eman8388/ETHlink8ADC/snapshot_device_example/Image 2025-03-31 at 12.25.28.jpeg

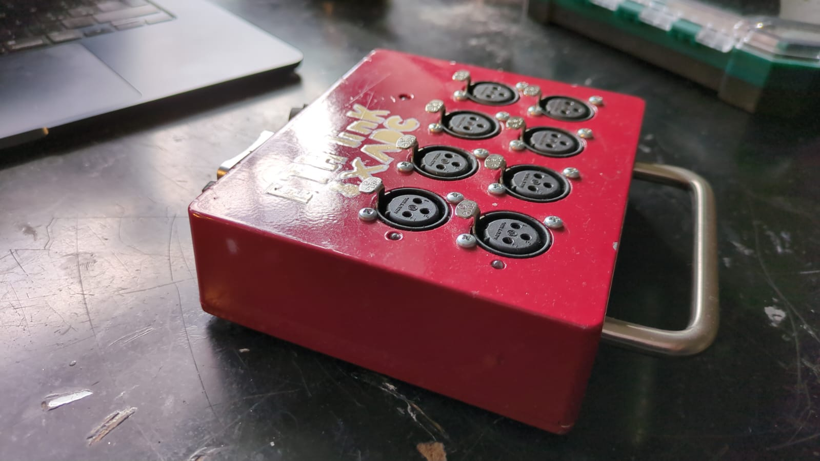
snapshot_device_example/Image 2025-03-31 at 12.25.28.jpeg
