eman8388/ETHlink8ADC/snapshot_PCB/3D_ETHlink8xADC_PCB_3D_2.png.png

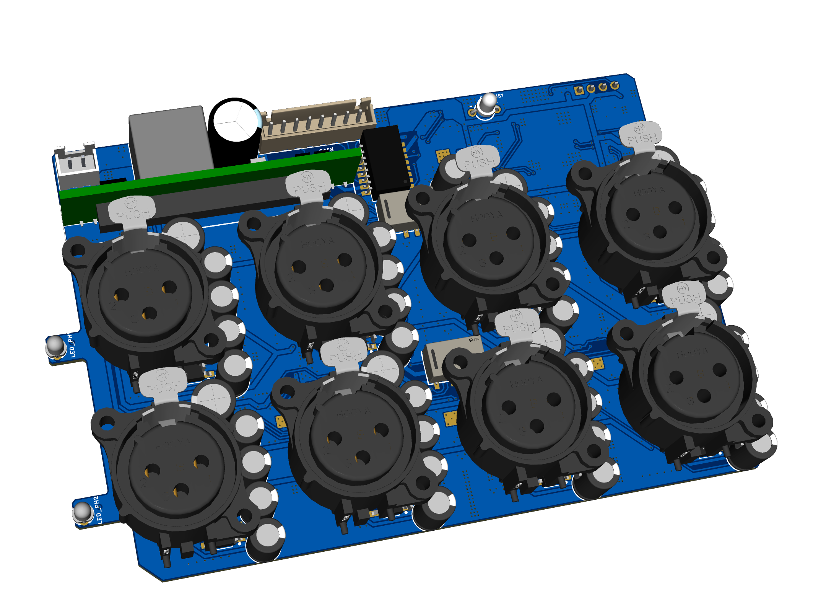
snapshot_PCB/3D_ETHlink8xADC_PCB_3D_2.png.png
