eman8388/ETHlink8ADC/PCB_BOM/BOM_ETHlink8xADC_ETHlink8xADC_Schematic.xlsx

No. | Comment | Designator | Footprint | Value | Manufacturer Part | Manufacturer | Supplier Part | Supplier | Quantity
1 | MB110S | B1,B2,B3,B4,B5,B6,B7,B8 | MBS_L4.7-W4.0-P2.50-LS7.0-TL |  | MB110S | MDD(辰达半导体) | C94545 | LCSC | 8
2 | 860020773013 | C1,C2,C3,C4,C20,C21,C22,C23,C32,C33,C34,C35,C44,C45,C46,C47,C57,C58,C59,C60,C69,C70,C71,C72,C81,C82,C83,C84,C93,C94,C95,C96,C240 | CAP-TH_BD6.3-P2.50-D0.5-FD |  | 860020773013 | Wurth(伍尔特) | C7046938 | LCSC | 33
3 | 100pF | C5,C13,C14,C25,C26,C37,C38,C48,C50,C51,C62,C63,C74,C75,C86,C87 | C0603 | 100pF | CL10C101JB8NNNC | SAMSUNG(三星) | C14858 | LCSC | 16
4 | 2.2nF | C6,C12,C24,C36,C49,C61,C73,C85 | C0603 | 2.2nF | GRM1885C1H222JA01D | muRata(村田) | C77033 | LCSC | 8
5 | 1000uF | C7,C17,C29,C41,C54,C66,C78,C90 | CAP-TH_BD8.0-P3.50-D0.6-FD-2 | 1000uF | 6.3YXS1000MEFC8X11.5 | rubycon(红宝石) | C5115430 | LCSC | 8
6 | 10uF | C8,C9,C15,C19,C27,C31,C39,C43,C52,C56,C64,C68,C76,C80,C88,C92,C97,C99,C100,C102,C104,C106,C108,C109,C111,C113,C184,C185,C194,C195,C196,C197,C202,C203,C204,C215,C218,C224 | C0603 | 10uF | CL10A106MQ8NNNC | SAMSUNG(三星) | C1691 | LCSC | 38
7 | 100nF | C10,C11,C16,C18,C28,C30,C40,C42,C53,C55,C65,C67,C77,C79,C89,C91,C98,C101,C103,C105,C107,C110,C112,C114,C115,C192,C193,C201,C214,C217,C223,C225,C230,C231,C232,C233,C234,C235,C236,C237,C241,C242 | C0603 | 100nF | CL10B104KC8NNNC | SAMSUNG(三星) | C15725 | LCSC | 42
8 | 1000uF | C198 | CAP-TH_BD10.0-P5.00-D1.0-FD | 1000uF | 25PK1000MEFC10*16 | rubycon(红宝石) | C109451 | LCSC | 1
9 | 1uF | C206,C207,C208,C210,C216 | C0603 | 1uF | CL10A105KB8NNNC | SAMSUNG(三星) | C15849 | LCSC | 5
10 | 10pF | C211,C219,C221 | C0603 | 10pF | CL10C100JB8NNNC | SAMSUNG(三星) | C1634 | LCSC | 3
11 | 4.7uF | C212 | C1210 | 4.7uF | HMK325C7475KN-TE | TAIYO YUDEN(太诱) | C697607 | LCSC | 1
12 | 470pF | C220 | C0603 | 470pF | CL10C471JC8NNNC | SAMSUNG(三星) | C525649 | LCSC | 1
13 | 2.2uF | C228,C229 | C0603 | 2.2uF | CL10A225KA8NNNC | SAMSUNG(三星) | C57895 | LCSC | 2
14 | 1N4148WS | D1,D2 | SOD-323_L1.7-W1.3-LS2.5-RD-1 |  | 1N4148WS | DIOTEC(德欧泰克) | C212832 | LCSC | 2
15 | SS34 | D3 | SMA_L4.3-W2.6-LS5.2-RD |  | SS34 | MDD | C8678 | LCSC | 1
16 | PMEG6010CEJ,115 | D4 | SOD-323F_L2.0-W1.6-LS2.5-RD |  | PMEG6010CEJ,115 | Nexperia(安世) | C406049 | LCSC | 1
17 | BZB984-C3V9,115 | D5,D6 | SOT-663-3_L1.6-W1.2-P1.00-LS1.6-BR |  | BZB984-C3V9,115 | Nexperia(安世) | C550162 | LCSC | 2
18 | MCP4017T-503E/LT | DP1,DP2,DP3,DP4,DP5,DP6,DP7,DP8 | SC-70-6_L2.0-W1.3-P0.65-LS2.1-BL |  | MCP4017T-503E/LT | MICROCHIP(美国微芯) | C478095 | LCSC | 8
19 | 4.7uH | L1 | IND-SMD_L7.0-W6.6_0630CDMCCDS | 4.7uH | 0630CDMCDDS-4R7MC | Sumida(胜美达) | C2453469 | LCSC | 1
20 | 6.8uH | L2 | IND-SMD_L7.3-W6.6 | 6.8uH | BMRA000606306R8MA1 | chilisin(奇力新) | C2838323 | LCSC | 1
21 | PT61017PEL | L3 | XFMR-SMD_PT61017PEL |  | PT61017PEL | BOURNS | C124001 | LCSC | 1
22 | 1uH | L4,L5 | L1008 | 1uH | LQM2HPN1R0MGHL | muRata(村田) | C162587 | LCSC | 2
23 | MHT192JGCT | LED1,LED2 | LED0603-RD |  | MHT192JGCT | MEIHUA(美华) | C473820 | LCSC | 2
24 | XL-302SURD | LED_PH1,LED_PH2 | LED-TH_BD3.8-P2.54-RD |  | XL-302SURD | XINGLIGHT(成兴光) | C2895470 | LCSC | 2
25 | DP9700 at-12V2A | POE_MODULE1 | PWRM-TH_DP9700-XX |  | DP9700 at-12V2A | SDAPO(达普) | C5380092 | LCSC | 1
26 | ZX-XH2.54-2PZZ | PWR_EXT1 | CONN-TH_2P-P2.50_HX25003-2A |  | ZX-XH2.54-2PZZ | Megastar(兆星) | C7429632 | LCSC | 1
27 | MMBT2222AT-7-F | Q1,Q2 | SOT-523-3_L1.6-W0.8-P1.00-LS1.6-BR |  | MMBT2222AT-7-F | DIODES(美台) | C151009 | LCSC | 2
28 | 10kΩ | R1,R2,R7,R8,R9,R10,R11,R12,R17,R18,R19,R20,R21,R22,R27,R28,R29,R30,R31,R32,R37,R38,R39,R40,R41,R42,R47,R48,R49,R50,R51,R52,R57,R58,R59,R60,R61,R62,R67,R68,R69,R70,R71,R72,R77,R78,R79,R80,R81,R82,R123,R144,R145,R146,R147 | R0603 | 10kΩ | RC0603FR-0710KL | YAGEO(国巨) | C98220 | LCSC | 55
29 | 12Ω | R3,R4,R13,R14,R23,R24,R33,R34,R43,R44,R53,R54,R63,R64,R73,R74 | R0603 | 12Ω | RC0603FR-0712RL | YAGEO(国巨) | C245909 | LCSC | 16
30 | 6.8kΩ | R5,R6,R15,R16,R25,R26,R35,R36,R45,R46,R55,R56,R65,R66,R75,R76 | R0805 | 6.8kΩ | AS05W2J0682T5E | UNI-ROYAL(厚声) | C560550 | LCSC | 16
31 | 4.7kΩ | R83,R84,R85,R86,R87,R88,R89,R90,R91,R92,R93,R94,R95,R96,R97,R98,R99,R116,R117,R134,R136,R137,R138,R140 | R0603 | 4.7kΩ | 0603WAF4701T5E | UNI-ROYAL(厚声) | C23162 | LCSC | 24
32 | 470Ω | R120,R121,R142,R143,R148,R149,R150,R151,R152 | R0603 | 470Ω | 0603WAF4700T5E | UNI-ROYAL(厚声) | C23179 | LCSC | 9
33 | 33kΩ | R124 | R0603 | 33kΩ | 0603WAF4702T5E | UNI-ROYAL(厚声) |  | LCSC | 1
34 | 1MΩ | R125 | R0603 | 1MΩ | 0603WAF1004T5E | UNI-ROYAL(厚声) | C22935 | LCSC | 1
35 | 34.8kΩ | R126 | R0603 | 34.8kΩ | 0603WAF3482T5E | UNI-ROYAL(厚声) | C23141 | LCSC | 1
36 | 47Ω | R127,R128,R129,R130,R132,R133,R139,R141 | R0603 | 47Ω | 0603WAF470JT5E | UNI-ROYAL(厚声) | C23182 | LCSC | 8
37 | 12.1kΩ | R131 | R0603 | 12.1kΩ | 0603WAF1212T5E | UNI-ROYAL(厚声) | C22864 | LCSC | 1
38 | 1.5kΩ | R135 | R0603 | 1.5kΩ | 0603WAF1501T5E | UNI-ROYAL(厚声) | C22843 | LCSC | 1
39 | B8B-XH-AM | RJ45 | CONN-TH_8P-P2.50_B8B-XH-AM-LF-SN |  | B8B-XH-AM | JST | C5306535 | LCSC | 1
40 | 209UYSYGW/S530-A3/R2 | STATUS1 | LED-TH_3P-BD4.0-P2.54 |  | 209UYSYGW/S530-A3/R2 | EVERLIGHT(亿光) | C409519 | LCSC | 1
41 | HB-PH3-25414PB2GOP | SW1 | HDR-TH_4P-P2.54-V-M |  | HB-PH3-25414PB2GOP | HANBO(汉博) | C6332197 | LCSC | 1
42 | LME49721MA/NOPB | U1,U2,U3,U4,U5,U6,U7,U8 | SOIC-8_L4.9-W3.9-P1.27-LS6.0-BL |  | LME49721MA/NOPB | TI(德州仪器) | C1348133 | LCSC | 8
43 | TLV320ADC6140IRTWT | U9,U10 | WQFN-24_L4.0-W4.0-P0.50-BL-EP2.1 |  | TLV320ADC6140IRTWT | TI(德州仪器) | C1852023 | LCSC | 2
44 | TCA9548ARGER | U11 | VQFN-24_L4.0-W4.0-P0.50-BL-EP2.5 |  | TCA9548ARGER | TI(德州仪器) | C555456 | LCSC | 1
45 | SI5351A-B-GTR | U16 | MSOP-10_L3.0-W3.0-P0.50-LS5.0-BL |  | SI5351A-B-GTR | SKYWORKS/SILICON LABS(芯科) | C504891 | LCSC | 1
46 | STM32H743VIT6 | U17 | LQFP-100_L14.0-W14.0-P0.50-LS16.0-BL |  | STM32H743VIT6 | ST(意法半导体) | C529058 | LCSC | 1
47 | AP62300WU-7 | U18 | TSOT-23-6_L2.9-W1.6-P0.95-LS2.8-BL |  | AP62300WU-7 | DIODES(美台) | C1880390 | LCSC | 1
48 | LD39200PUR | U19,U20 | DFN-6_L3.0-W3.0-P0.95-BL-EP-1 |  | LD39200PUR | ST(意法半导体) | C2969757 | LCSC | 2
49 | LT8330ES6#TRPBF | U21 | TSOT-23-6_L2.9-W1.6-P0.95-LS2.8-BR |  | LT8330ES6#TRPBF | ADI(亚德诺) | C673741 | LCSC | 1
50 | LAN8742A-CZ | U22 | QFN-24_L4.0-W4.0-P0.50-BL-EP2.6 |  | LAN8742A-CZ | MICROCHIP(美国微芯) | C220794 | LCSC | 1
51 | UD2-3NUN | U23,U24 | RELAY-SMD_KEMET_UD2-XXNUN |  | UD2-3NUN | KEMET(基美) | C1560780 | LCSC | 2
52 | 25MHz | X1,X2 | CRYSTAL-SMD_4P-L3.2-W2.5-BL | 25MHz | 7M-25.000MEEQ-T | TXC(晶技) | C2450106 | LCSC | 2
53 | NC3FAAV1 | XLR1,XLR2,XLR3,XLR4,XLR5,XLR6,XLR7,XLR8 | CONN-TH_NC3FAAV1 |  | NC3FAAV1 | NEUTRIK(优曲克) | C368513 | LCSC | 8
