eman8388/ETHlink8ADC/PCB_Schematic/SCH_ETHlink8xADC_Schematic.pdf

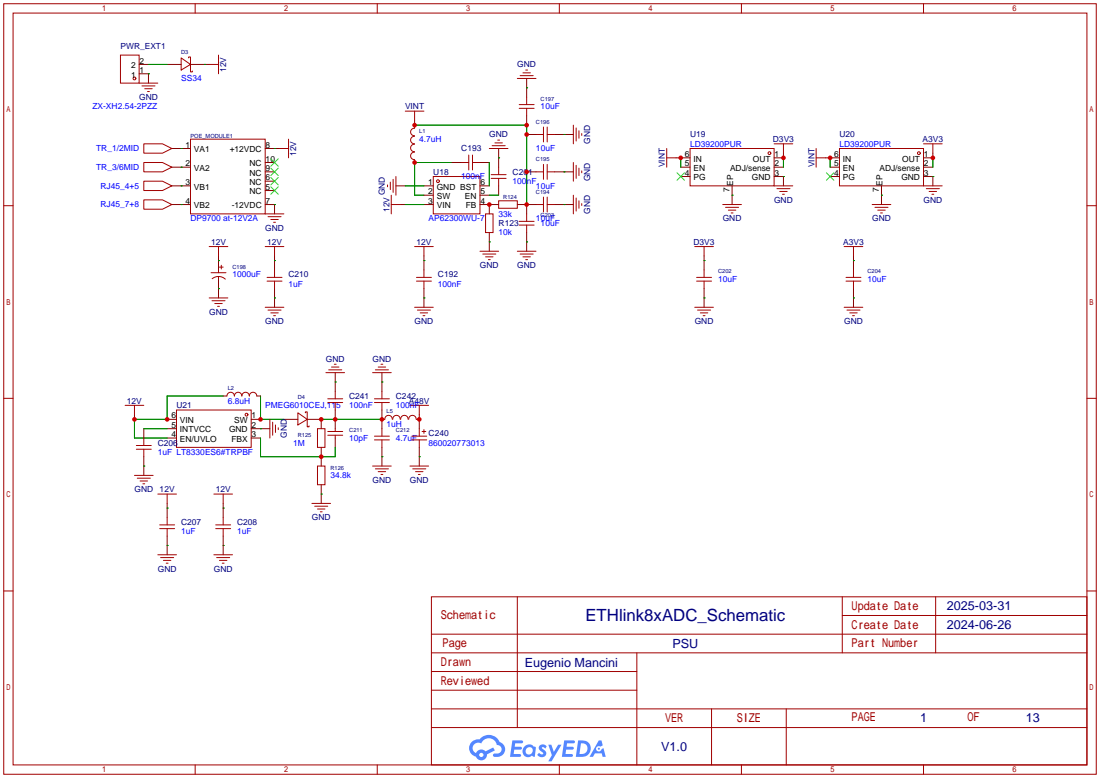
[picture p6: page 1]

VDD 50 PB12 51 PB13 52 PB14 53 PB15 54 PD8 55 PD9 56 PD10 57 PD11 58 PD12 59 PD13 60 PD14 61 PD15 62 PC6 63 PC7 64 PC8 65 PC9 66 PA8 67 PA9 68 PA10 69 PA11 70 PA12 71 PA13 72 VCAP 73 VSS 74 VDD 75 PA14 76 PA15 77 PC10 78 PC11 79 PC12 80 PD0 81 PD1 82 PD2 83 PD3 84 PD4 85 PD5 86 PD6 87 PD7 88 PB3 89 PB4 90 PB5 91 PB6 92 PB7 93 BOOT0 94 PB8 95 PB9 96 PE0 97 PE1 98 VSS 99 VDD 100

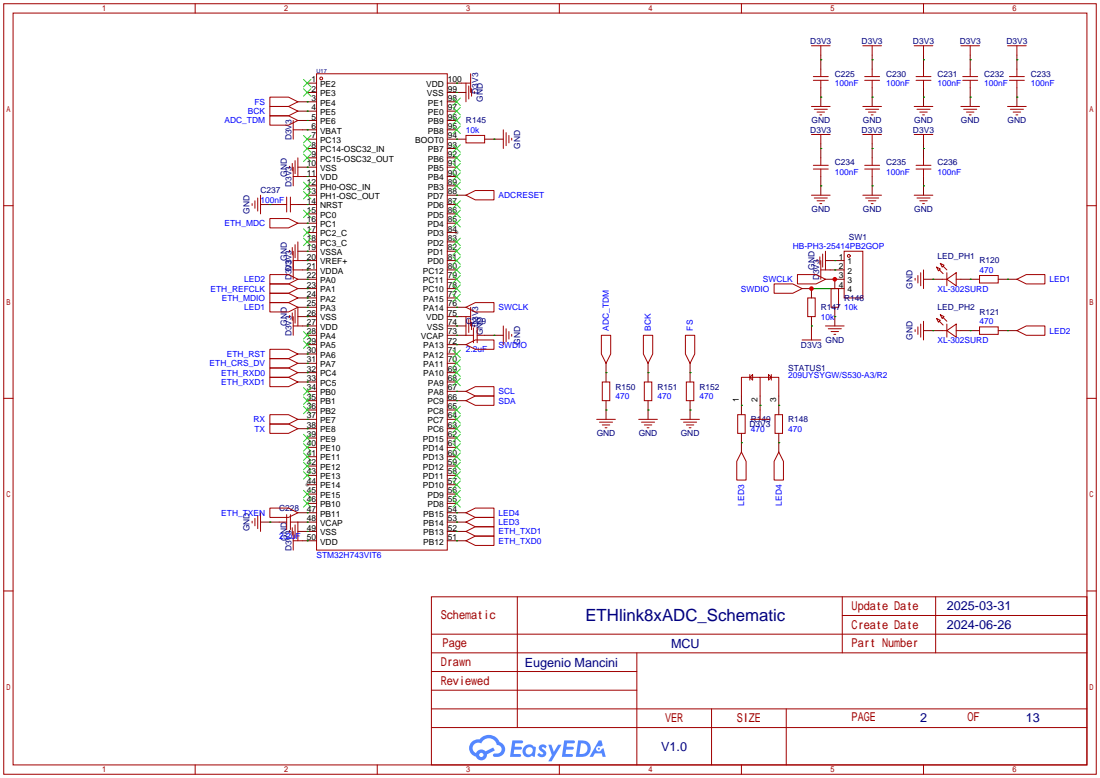
[picture p7: page 2]

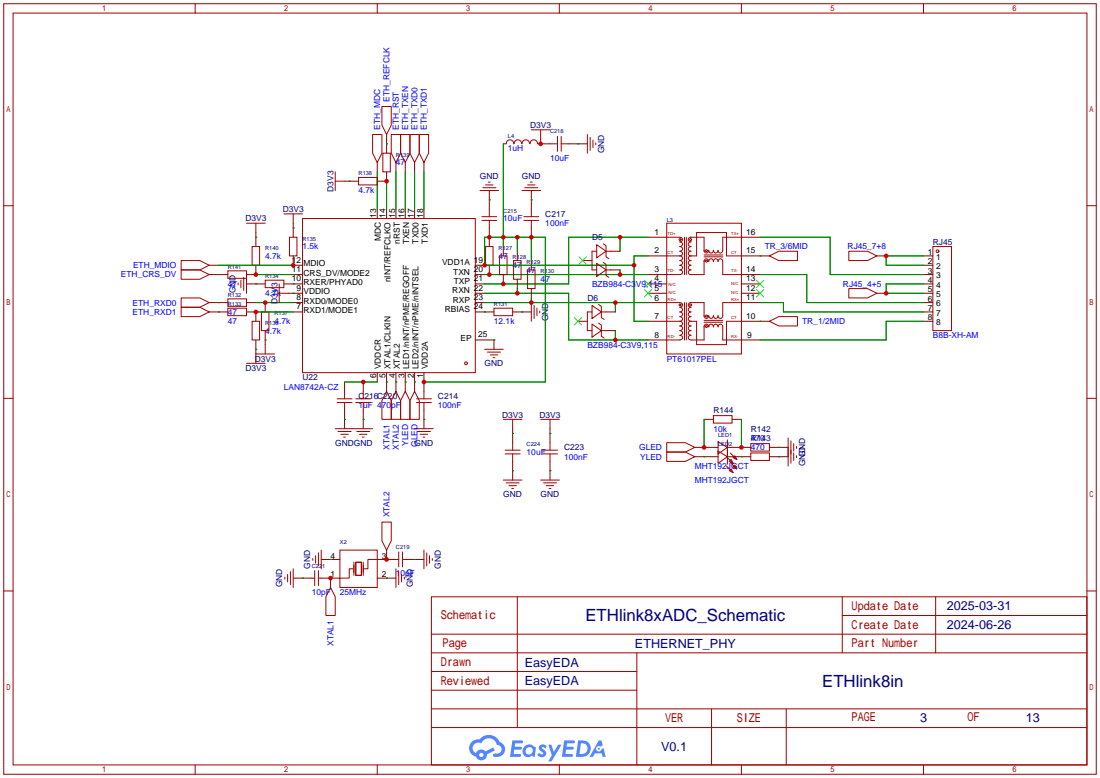
[picture p8: page 3]

TXD1 18 TXD0 17 TXEN 16 nRST 15 nINT/REFCLKO 14 MDC 13

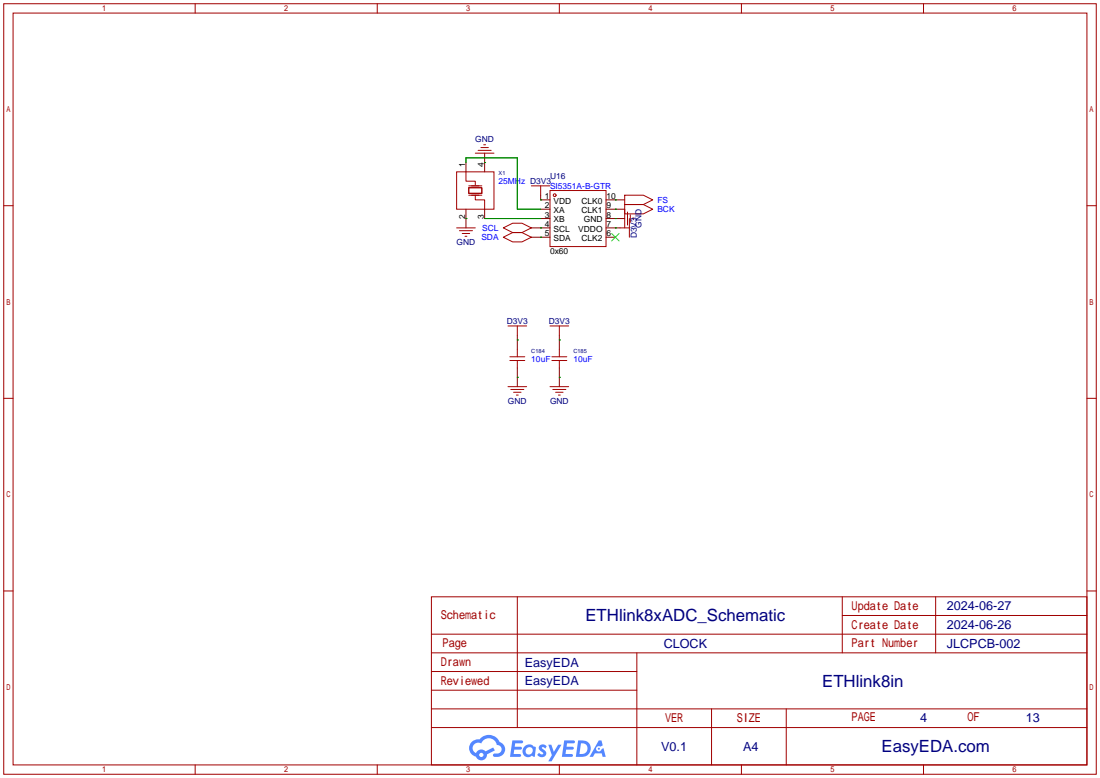
[picture p9: page 4]

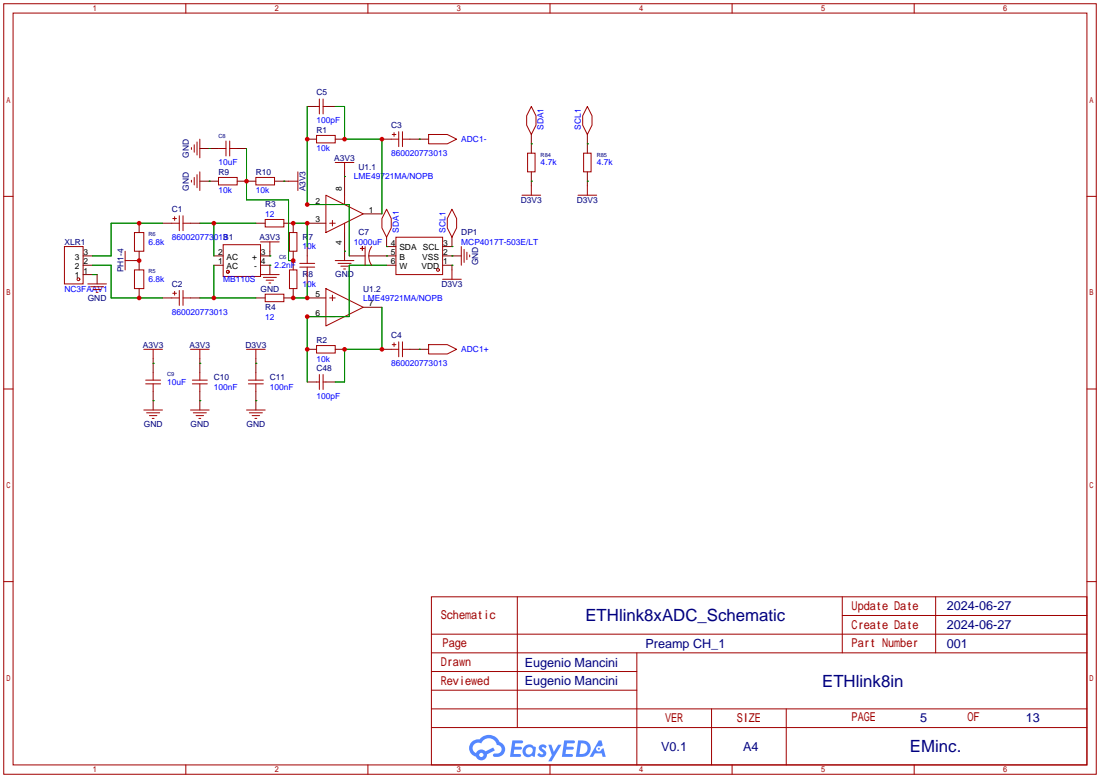
[picture p10: page 5]

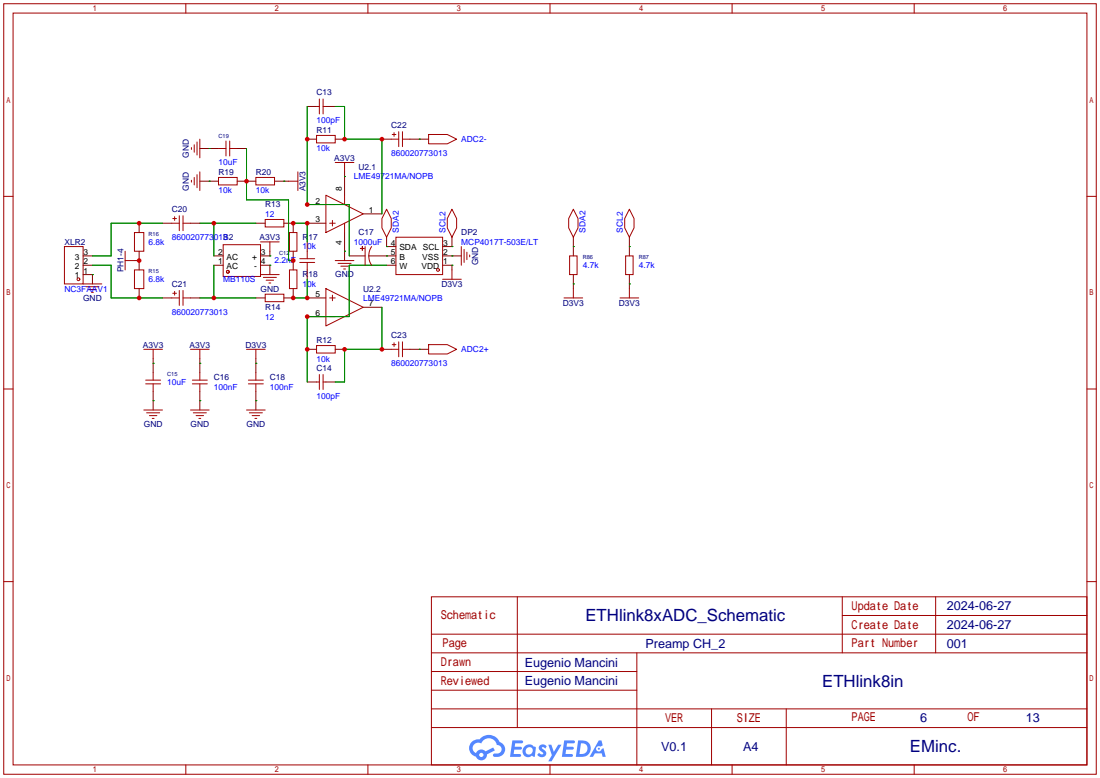
[picture p11: page 6]

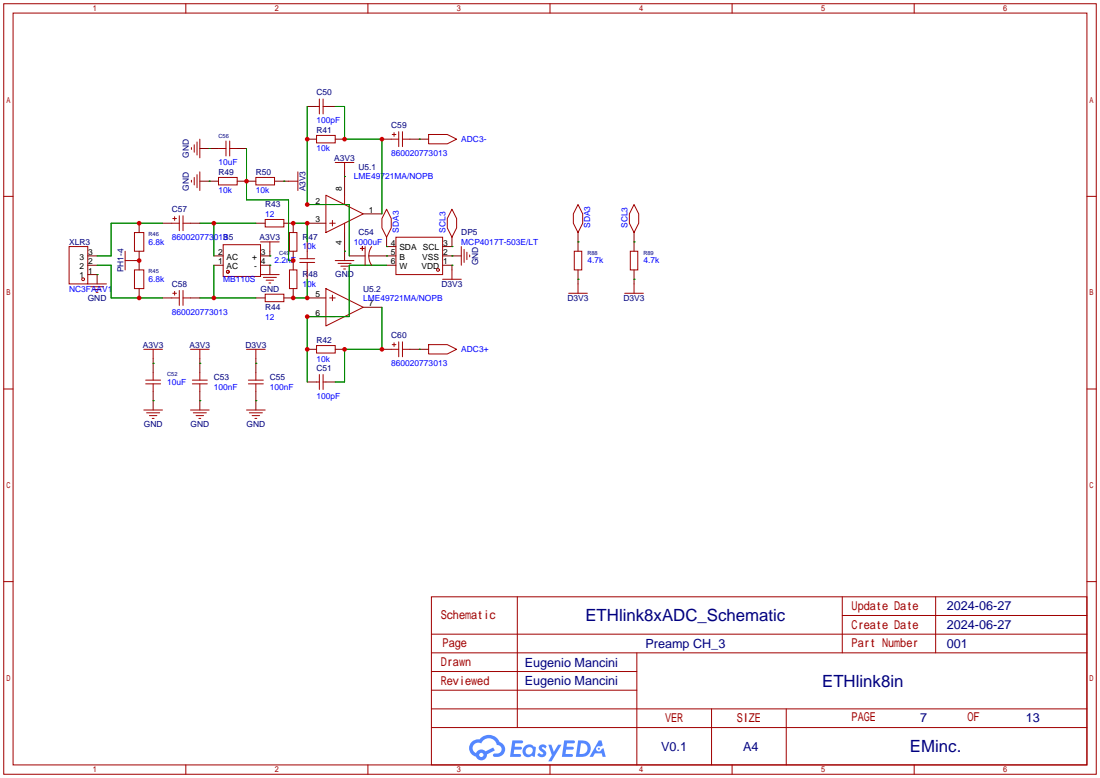
[picture p12: page 7]

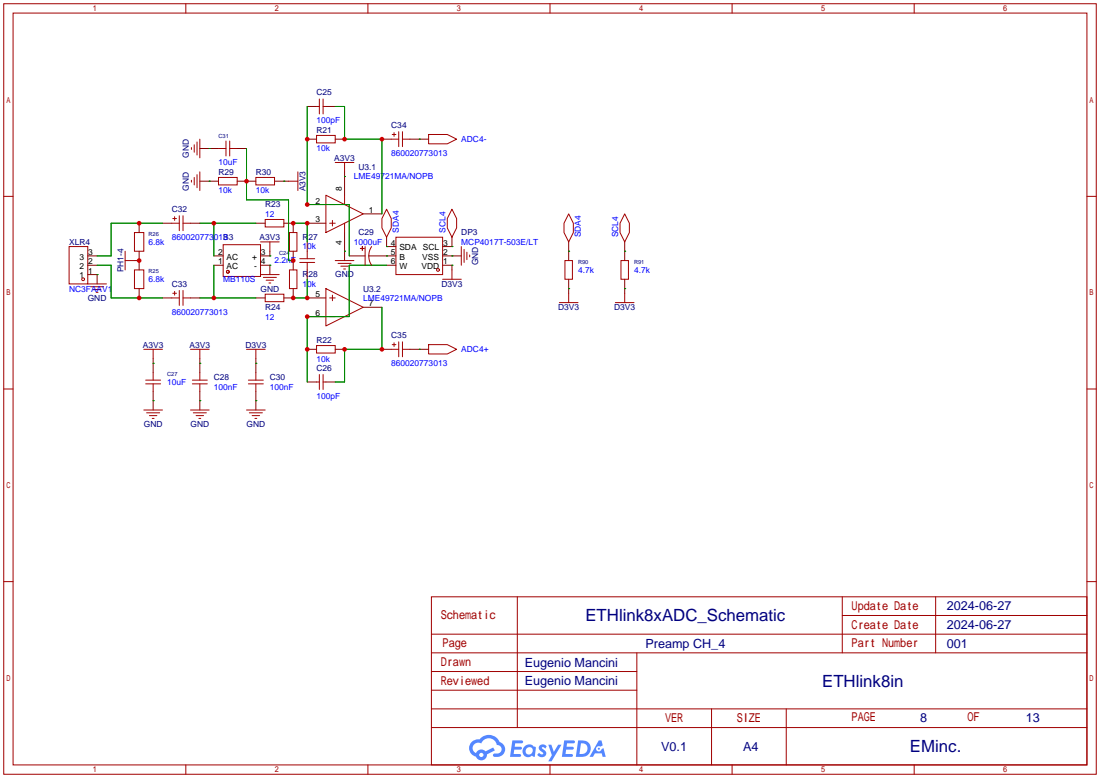
[picture p13: page 8]

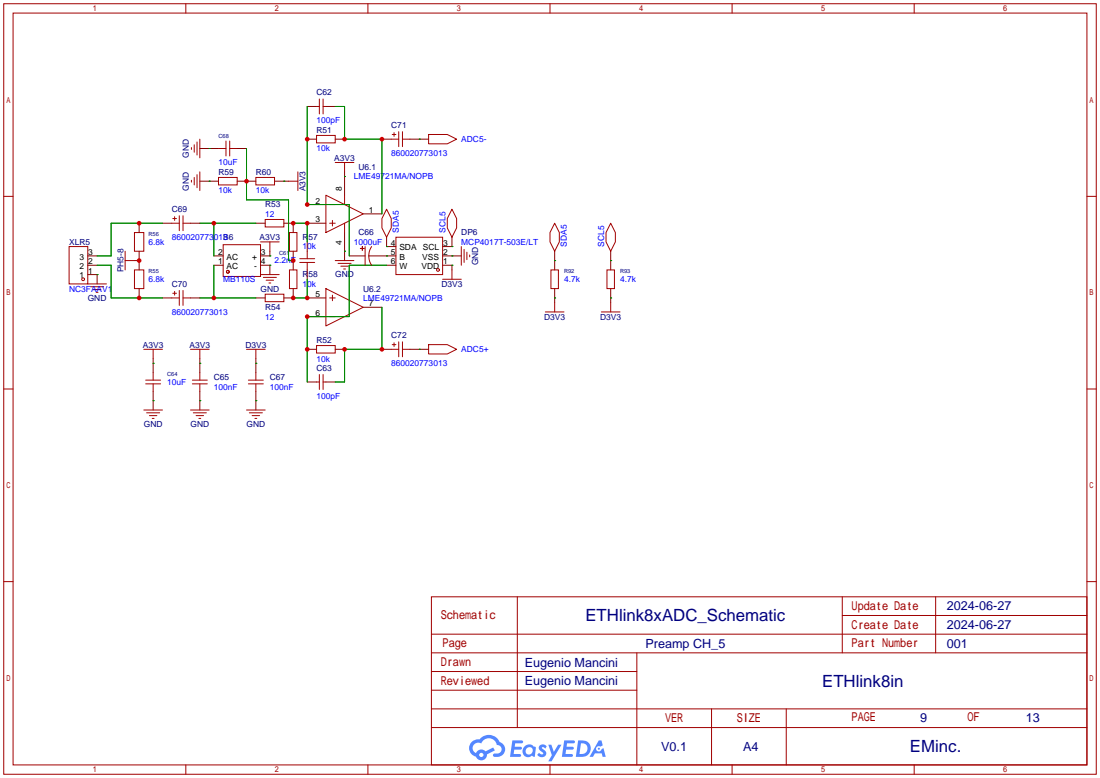
[picture p14: page 9]

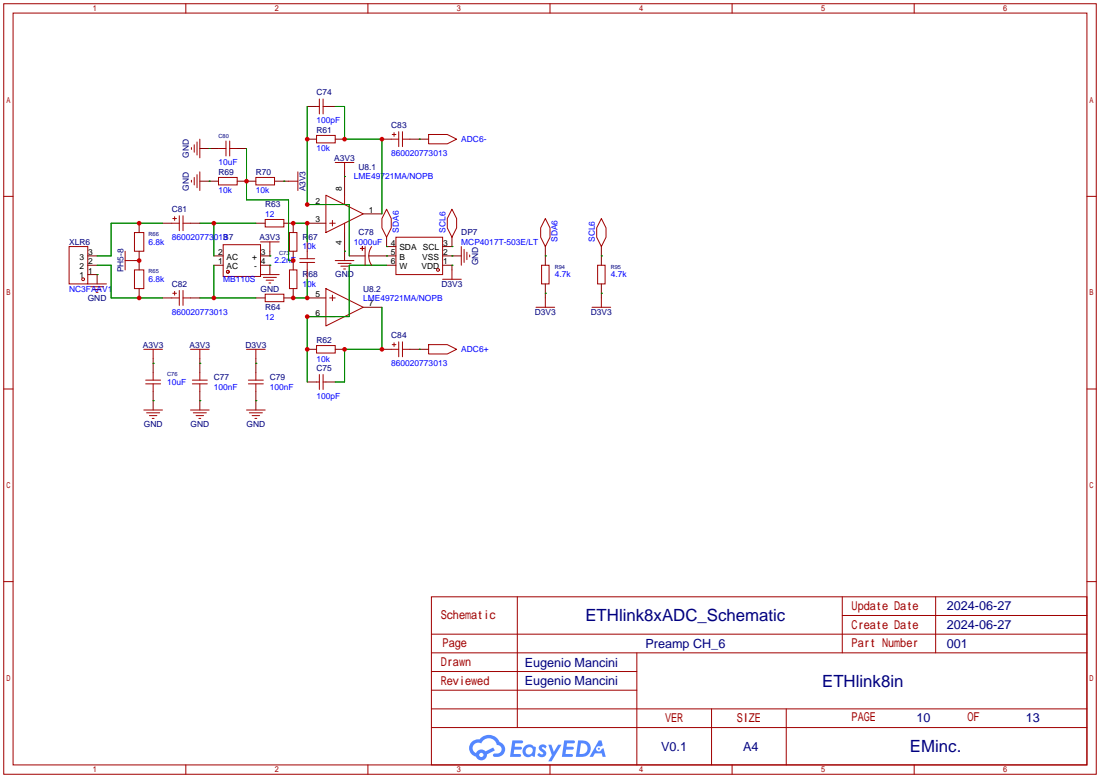
[picture p15: page 10]

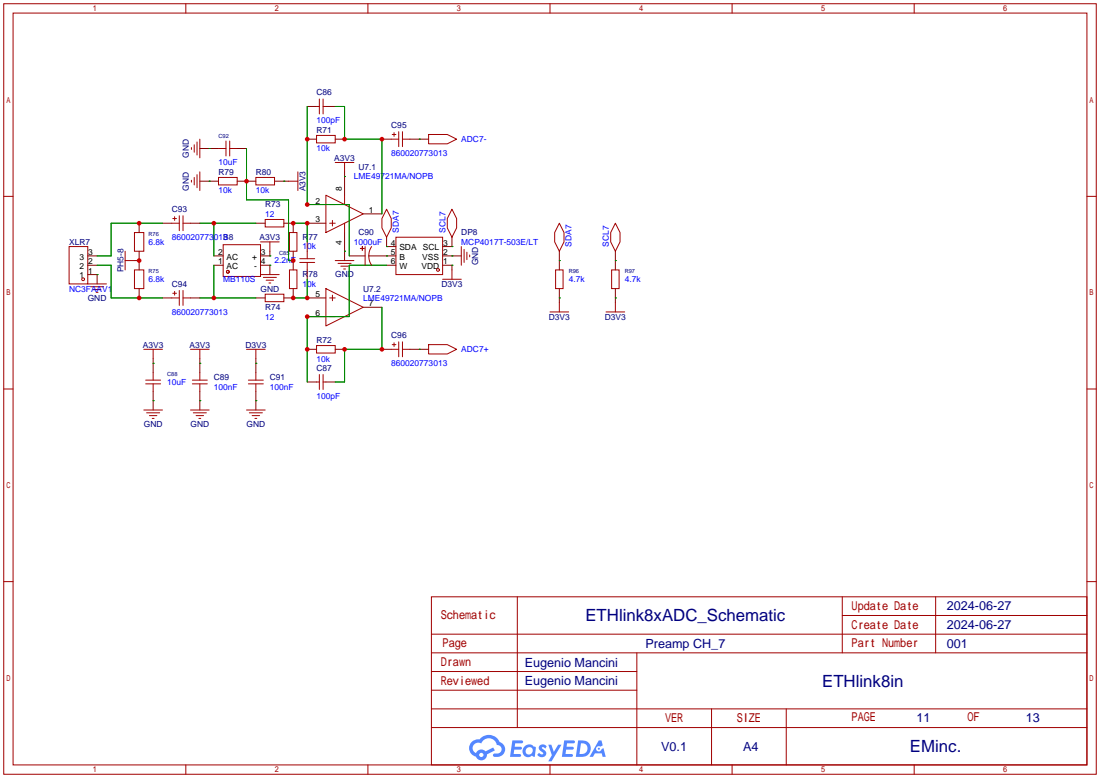
[picture p16: page 11]

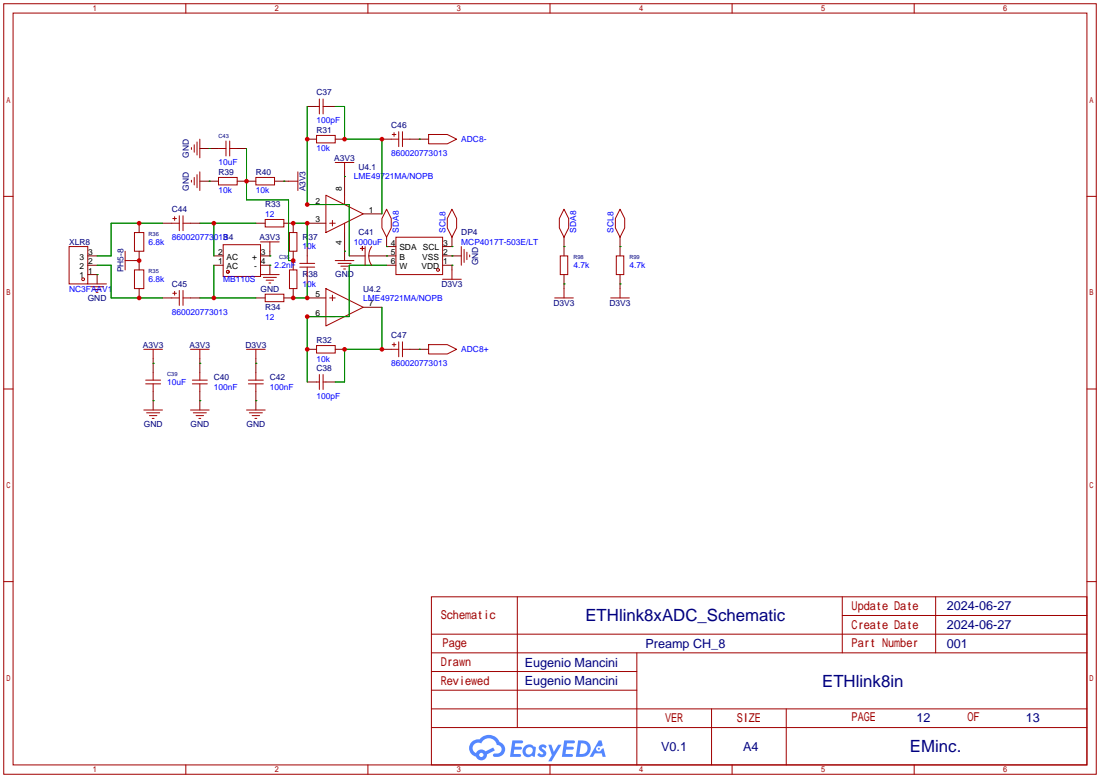
[picture p17: page 12]

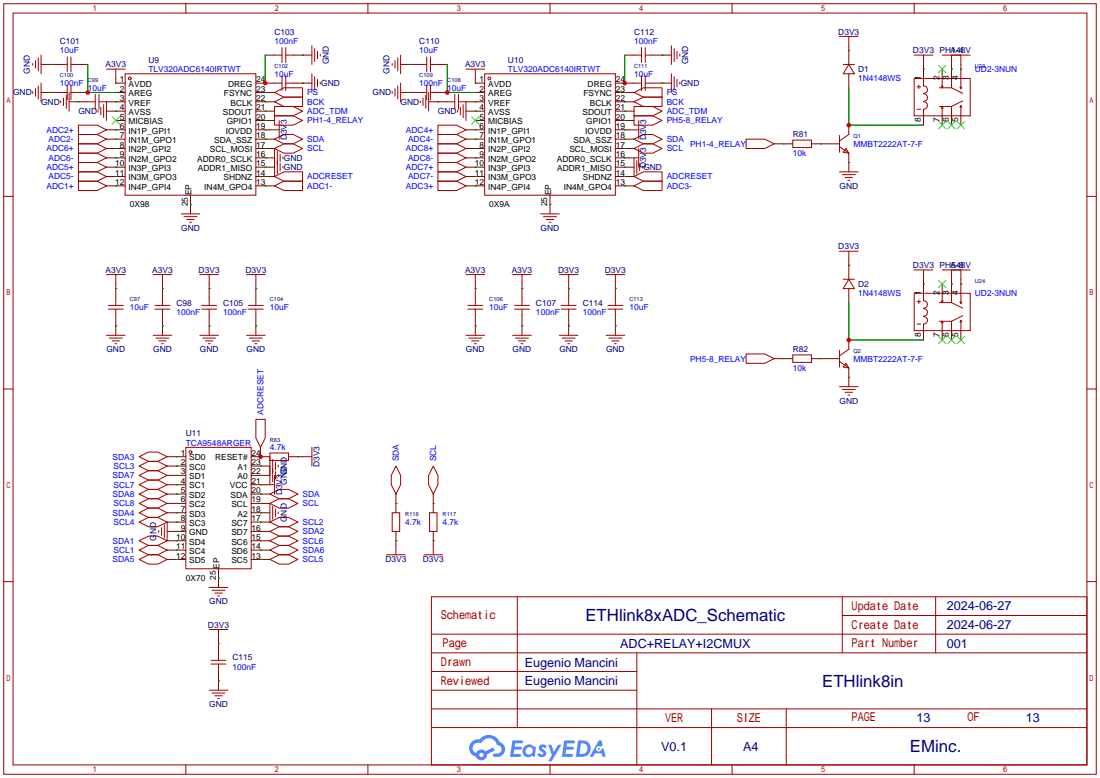
[picture p18: page 13]
