eman8388/ETHlink8ADC/(list of files, drawings)

Other design files:
PCB_EasyEDAPro_Project/ProPrj_ETHlink8xADC_2025-03-31.epro
